js-lm/Photoacoustic-Music-Box/pcb/led_driver.kicad_pcb

## KiCad design pcb/led_driver.kicad_pcb (2026-10-11)

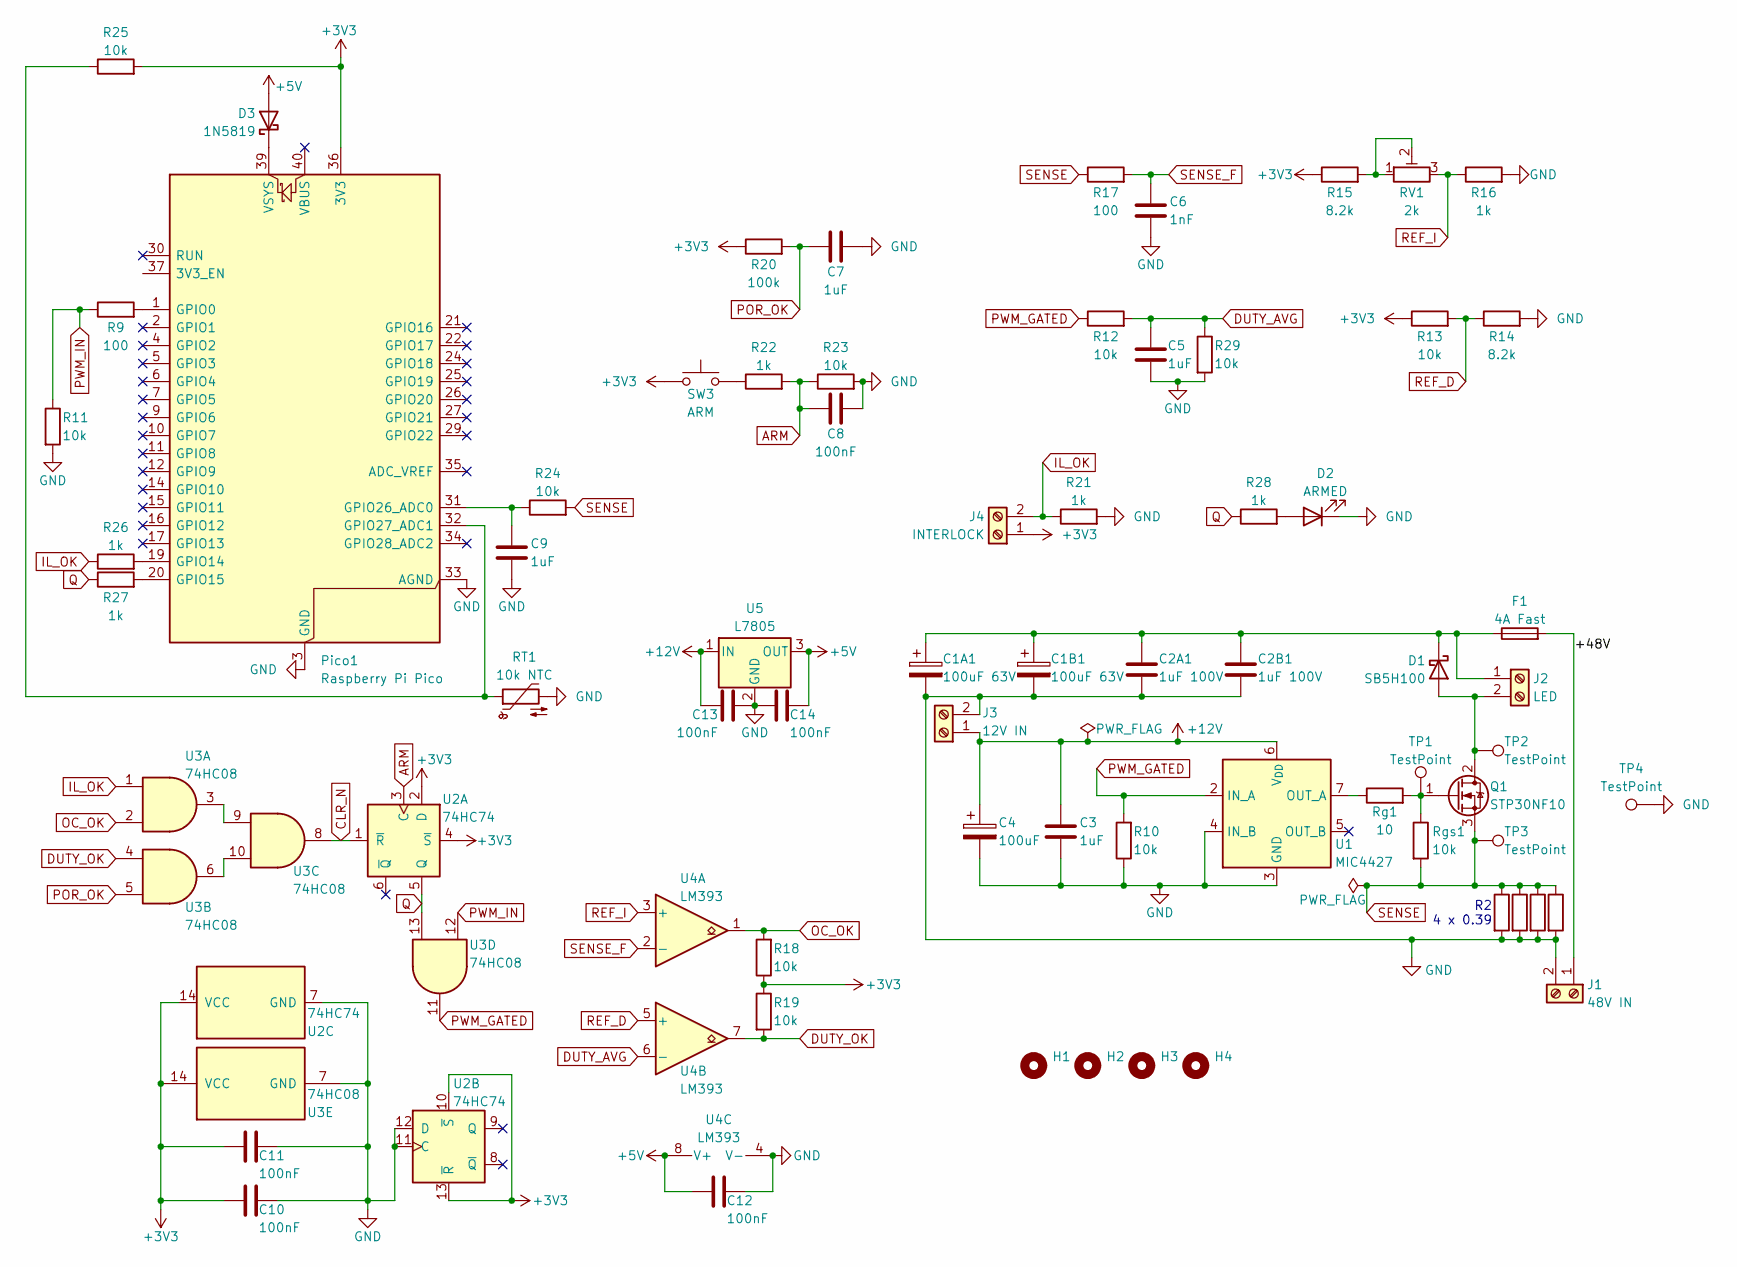
[picture p2: schematic led_driver.kicad_sch, Fast-Switching LED Driver]

Parts:
C1A1, C1B1: 100uF 63V; CP_Radial_D10.0mm_P5.00mm
C2A1, C2B1: 1uF 100V; C_Rect_L7.2mm_W4.5mm_P5.00mm_FKS2_FKP2_MKS2_MKP2
C3, C5, C7, C9: 1uF; C_Rect_L7.2mm_W4.5mm_P5.00mm_FKS2_FKP2_MKS2_MKP2
C4: 100uF; CP_Radial_D6.3mm_P2.50mm
C6: 1nF; C_Rect_L7.2mm_W4.5mm_P5.00mm_FKS2_FKP2_MKS2_MKP2
C8, C10, C11, C12, C13, C14: 100nF; C_Rect_L7.2mm_W4.5mm_P5.00mm_FKS2_FKP2_MKS2_MKP2
D1: SB5H100; D_DO-201AD_P5.08mm_Vertical_CathodeUp
D2: ARMED; LED_D5.0mm
D3: 1N5819; D_DO-41_SOD81_P10.16mm_Horizontal
F1: 4A Fast; Fuseholder_Cylinder-5x20mm_Schurter_0031_8201_Horizontal_Op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
H1, H2, H3, H4: MountingHole; MountingHole_2.2mm_M2
J1: 48V IN; TerminalBlock_Phoenix_MKDS-1,5-2-5.08_1x02_P5.08mm_Horizont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
J2: LED; TerminalBlock_Phoenix_MKDS-1,5-2-5.08_1x02_P5.08mm_Horizont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
J3: 12V IN; TerminalBlock_Phoenix_MKDS-1,5-2-5.08_1x02_P5.08mm_Horizont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
J4: INTERLOCK; TerminalBlock_Phoenix_MKDS-1,5-2-5.08_1x02_P5.08mm_Horizont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
Pico1: Raspberry Pi Pico; RaspberryPi_Pico_Common_THT
Q1: STP30NF10; TO-220-3_Vertical
R2A1, R2B1, R2C1, R2D1: 0.39; R_Axial_DIN0207_L6.3mm_D2.5mm_P2.54mm_Vertical
R9, R17: 100; R_Axial_DIN0207_L6.3mm_D2.5mm_P10.16mm_Horizontal
R10, R11, R12, R13, R18, R19, R23, R24, R25, R29: 10k; R_Axial_DIN0207_L6.3mm_D2.5mm_P10.16mm_Horizontal
R14, R15: 8.2k; R_Axial_DIN0207_L6.3mm_D2.5mm_P10.16mm_Horizontal
R16, R21, R22, R26, R27, R28: 1k; R_Axial_DIN0207_L6.3mm_D2.5mm_P10.16mm_Horizontal
R20: 100k; R_Axial_DIN0207_L6.3mm_D2.5mm_P10.16mm_Horizontal
RT1: 10k NTC; PinHeader_1x02_P2.54mm_Vertical
RV1: 2k; Potentiometer_Bourns_3296W_Vertical
Rg1: 10; R_Axial_DIN0207_L6.3mm_D2.5mm_P2.54mm_Vertical
Rgs1: 10k; R_Axial_DIN0207_L6.3mm_D2.5mm_P2.54mm_Vertical
SW3: ARM; SW_PUSH_6mm
TP1, TP2, TP3, TP4: TestPoint; TestPoint_THTPad_D2.0mm_Drill1.0mm
U1: MIC4427; SOIC-8_3.9x4.9mm_P1.27mm
U2: 74HC74; DIP-14_W7.62mm
U3: 74HC08; DIP-14_W7.62mm
U4: LM393; DIP-8_W7.62mm
U5: L7805; TO-220-3_Vertical

Connections:
+3V3: C10.1, C11.1, J4.1, Pico1.36 (3V3), R13.1, R15.1, R18.1, R19.1, R20.1, R25.2, SW3.1, U2.2 (D), U2.4 (~S), U2.10 (~S), U2.13 (~R), U2.14 (VCC), U3.14 (VCC)
+5V: C12.1, C14.2, D3.2 (A), U4.8 (V+), U5.3 (OUT)
+12V: C3.1, C4.1, C13.1, J3.1, U1.6 (V_{DD}), U5.1 (IN)
/+48V: F1.2, J1.1
ARM: C8.1, R22.2, R23.1, U2.3 (C)
CLR_N: U2.1 (~R), U3.8
DUTY_AVG: C5.1, R12.2, R29.1, U4.6 (-)
DUTY_OK: R19.2, U3.4, U4.7
GND: C1A1.2, C1B1.2, C2A1.2, C2B1.2, C3.2, C4.2, C5.2, C6.2, C7.2, C8.2, C9.2, C10.2, C11.2, C12.2, C13.2, C14.1, D2.1 (K), J1.2, J3.2, Pico1.3 (GND), Pico1.8 (GND), Pico1.13 (GND), Pico1.18 (GND), Pico1.23 (GND), Pico1.28 (GND), Pico1.33 (AGND), Pico1.38 (GND), R2A1.2, R2B1.2, R2C1.2, R2D1.2, R10.1, R11.2, R14.2, R16.2, R21.2, R23.2, R29.2, RT1.2, TP4.1 (1_1), U1.3 (GND), U1.4 (IN_B), U2.7 (GND), U2.11 (C), U2.12 (D), U3.7 (GND), U4.4 (V-), U5.2 (GND)
IL_OK: J4.2, R21.1, R26.1, U3.1
unnamed: D1.2 (A), J2.2, Q1.2 (D), TP2.1 (1_1)
unnamed: C1A1.1, C1B1.1, C2A1.1, C2B1.1, D1.1 (K), F1.1, J2.1
unnamed: D2.2 (A), R28.2
unnamed: D3.1 (K), Pico1.39 (VSYS)
unnamed: Pico1.1 (GPIO0), R9.2
unnamed: Pico1.19 (GPIO14), R26.2
unnamed: Pico1.20 (GPIO15), R27.2
unnamed: C9.1, Pico1.31 (GPIO26_ADC0), R24.1
unnamed: Pico1.32 (GPIO27_ADC1), R25.1, RT1.1
unnamed: Q1.1 (G), Rg1.2, Rgs1.1, TP1.1 (1_1)
unnamed: R15.2, RV1.1, RV1.2
unnamed: R22.1, SW3.2
unnamed: Rg1.1, U1.7 (OUT_A)
unnamed: U3.3, U3.9
unnamed: U3.6, U3.10
OC_OK: R18.2, U3.2, U4.1
POR_OK: C7.1, R20.2, U3.5
PWM_GATED: R10.2, R12.1, U1.2 (IN_A), U3.11
PWM_IN: R9.1, R11.1, U3.12
Q: R27.1, R28.1, U2.5 (Q), U3.13
REF_D: R13.2, R14.1, U4.5 (+)
REF_I: R16.1, RV1.3, U4.3 (+)
SENSE: Q1.3 (S), R2A1.1, R2B1.1, R2C1.1, R2D1.1, R17.1, R24.2, Rgs1.2, TP3.1 (1_1)
SENSE_F: C6.1, R17.2, U4.2 (-)

Notes on the sheet:
R2 4 x 0.39

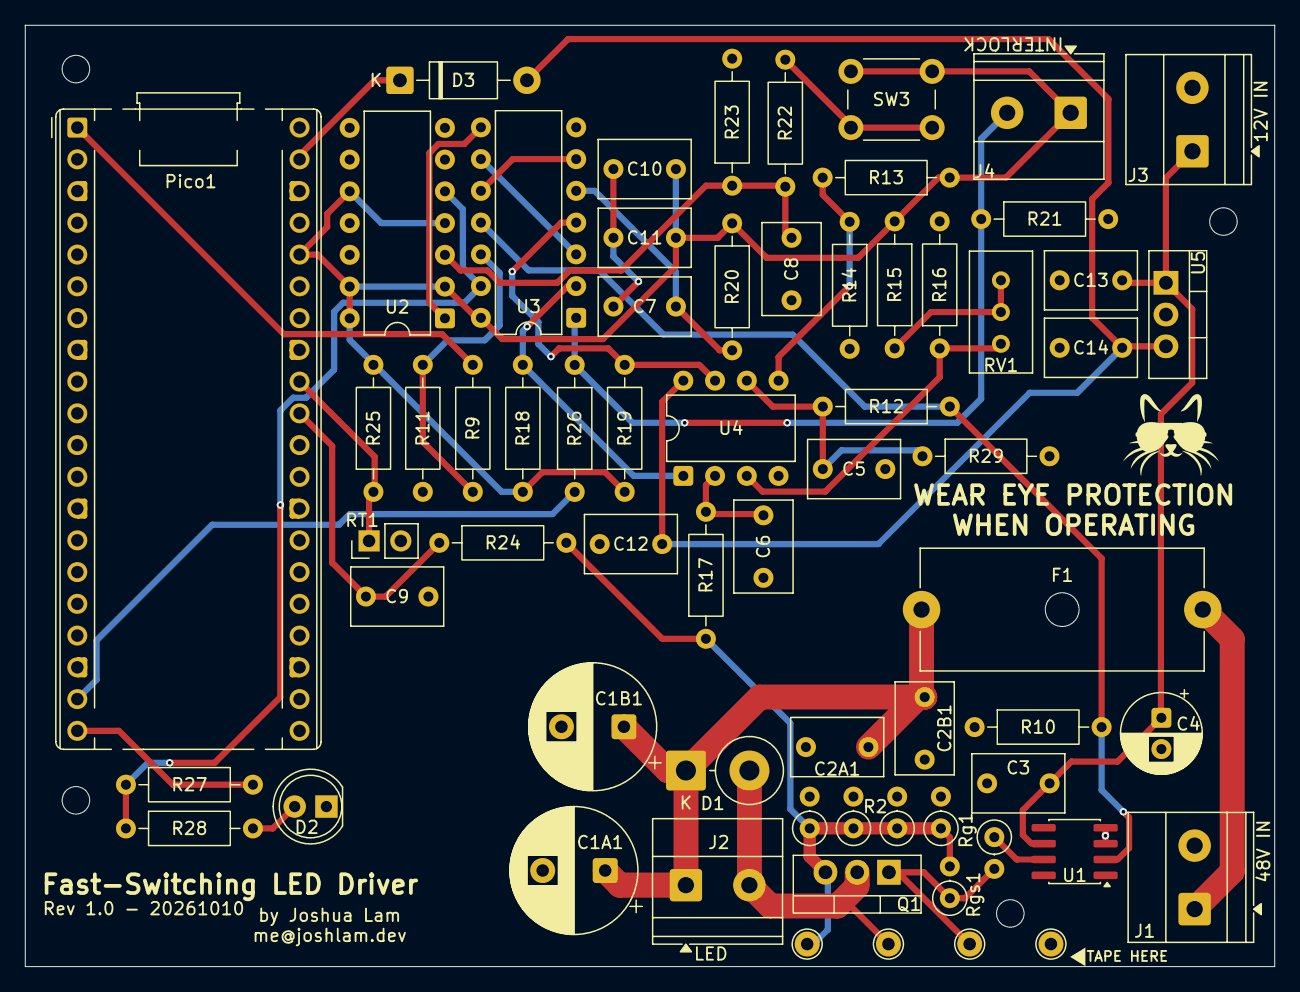
[picture p3: board led_driver.kicad_pcb from above]

Board: 2 copper layers, 100.0 x 75.3 mm, 69 parts (0 on the bottom side), 34 nets.
