js-lm/Photoacoustic-Music-Box/(commit log)

2026-10-08 Add LED driver KiCad project (WIP)
    Decided to merge into one main repo instead of keeping a separate hardware repo
    [led_driver.kicad_pcb, led_driver.kicad_sch]
2026-10-09 Initial routing for LED driver
    [led_driver.kicad_pcb, led_driver.kicad_sch]
2026-10-10 Fix some constraint error and violations
    [led_driver.kicad_pcb, led_driver.kicad_sch]
2026-10-11 First revision
    [led_driver.kicad_pcb, led_driver.kicad_sch]
2026-10-17 Move kicad gitignore to pcb directory
